pmamonov/PulsePal/CAD/PCB/r2_0/kicad/PulsePalSMT_Rev_0_5.kicad_pcb

## KiCad design CAD/PCB/r2_0/kicad/PulsePalSMT_Rev_0_5.kicad_pcb (2017-06-04)

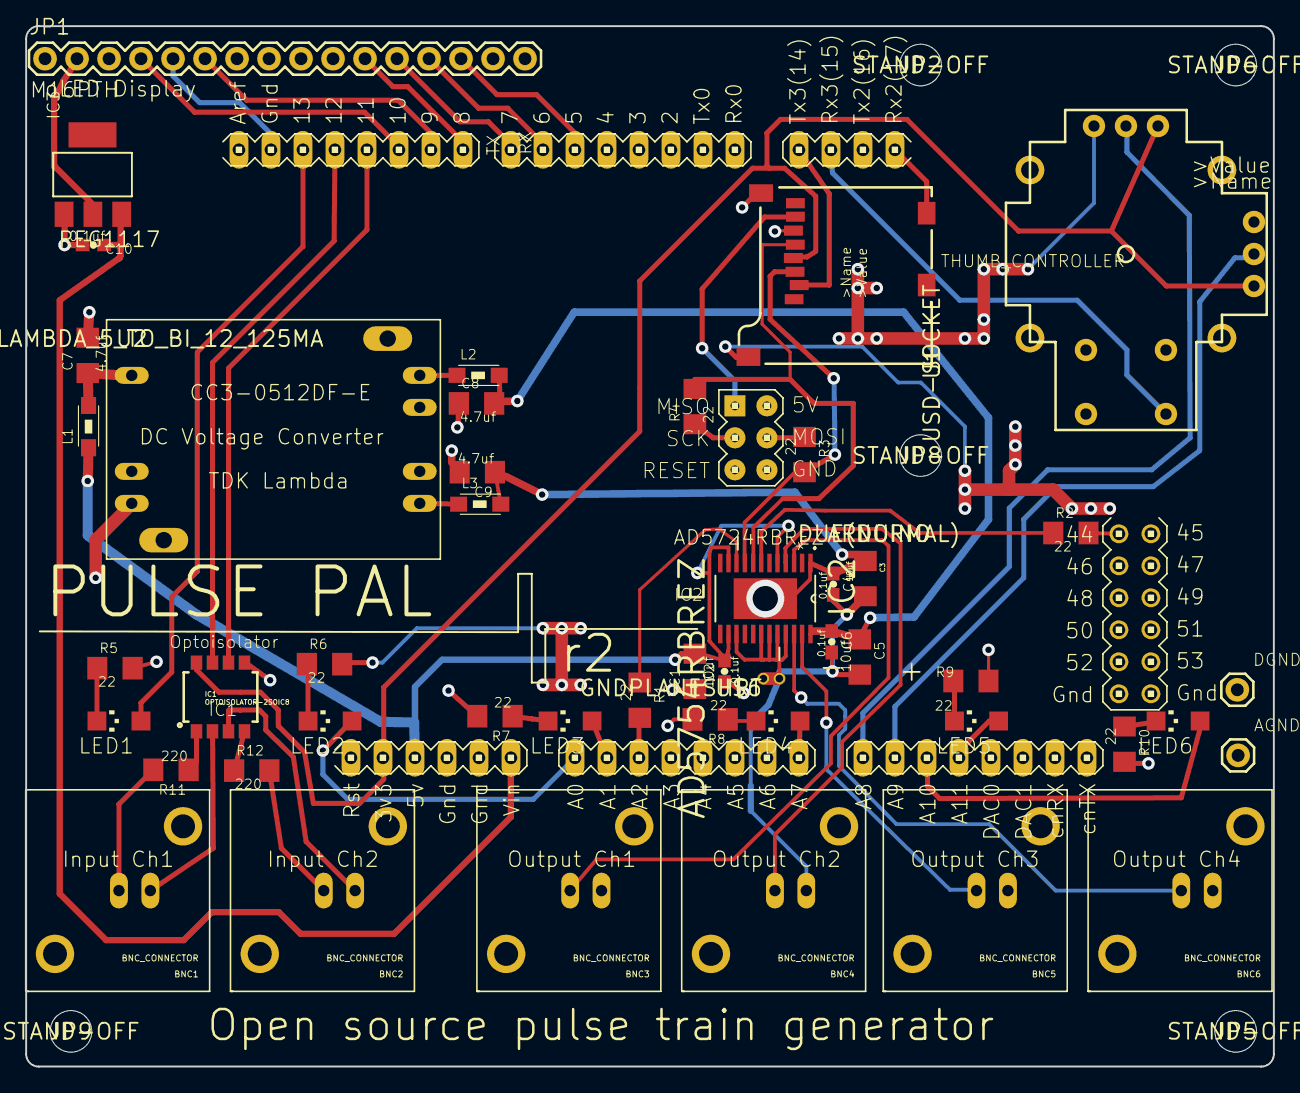
[picture p1: board PulsePalSMT_Rev_0_5.kicad_pcb from above]

Board: 4 copper layers, 99.0 x 82.6 mm, 53 parts (0 on the bottom side), 55 nets.

Parts:
AGND: 1X01
ARDUINO: DUE(NORMAL)
BNC1, BNC2, BNC3, BNC4, BNC5, BNC6: BNC_CONNECTOR
C1, C3, C5: 10uf; 1206
C2, C4, C6, C10: 0.1uf; 0603-CAP
C7, C8, C9: 4.7uf; 1206
DGND: 1X01
IC1: OPTOISOLATOR-2SOIC8; SO08-2
IC2: AD5754RBREZ; SOP65P640X120-25N
IC3: REG1117; SOT223
JP1: M16PTH; 1X16
JP2, JP5, JP6, JP8, JP9: STAND-OFF
L1, L2, L3: 1206
LED1, LED2, LED3, LED4, LED5, LED6: CHIPLED_1206
R1, R2, R3, R4, R5, R6, R7, R8, R9, R10: 22; 1206
R11, R12: 220; 1206
THUMB_CONTROLLER: JOYSTICK
U1: USD-SOCKET; MICROSD_1%3a1
U2: TDK_LAMBDA_5_TO_BI_12_125MA
U$6: GNDPLANESHRT

Connections:
5V: ARDUINO.5V, C1.2, C2.2, IC2.5, IC2.11, IC2.14, L1.1
AGND: AGND.1, BNC3.GND, BNC4.GND, BNC5.GND, BNC6.GND, C3.2, C4.2, C5.2, C6.2, IC2.15, IC2.18, IC2.19, IC2.20, IC2.21, U$6.AGND
GND: ARDUINO.GND1, ARDUINO.GND_, C1.1, C2.1, C7.2, C8.1, C9.2, C10.2, DGND.1, IC1.5, IC3.1, JP1.1, JP1.5, R5.2, R6.2, R7.2, R8.2, R9.2, R10.2, THUMB_CONTROLLER.B2A, THUMB_CONTROLLER.H3, THUMB_CONTROLLER.V3, U1.6, U1.GND1, U1.GND3, U2.P$2, U2.P$3, U2.P$5, U$6.GND
H_NAV: ARDUINO.VIN, C10.1, IC3.3
LED2: ARDUINO.A0, LED2.A
LED3: ARDUINO.A1, LED3.A
LED4: ARDUINO.A7, LED4.A
LED5: ARDUINO.A11, LED5.A
LED6: ARDUINO.A10, LED6.A
MISO1: ARDUINO.MISO, U1.7
unnamed: L2.1, U2.P$7
unnamed: L3.1, U2.P$4
unnamed: BNC3.SIGN, IC2.3
unnamed: BNC4.SIGN, IC2.4
unnamed: BNC5.SIGN, IC2.23
unnamed: BNC6.SIGN, IC2.22
unnamed: BNC1.GND, IC1.2
unnamed: BNC1.SIGN, R11.2
unnamed: BNC2.GND, IC1.3
unnamed: BNC2.SIGN, R12.2
unnamed: ARDUINO.SCK, R4.1
unnamed: ARDUINO.MOSI, R3.1
unnamed: ARDUINO.44, R2.2
unnamed: ARDUINO.A2, R1.2
unnamed: IC2.7, R2.1
unnamed: IC2.10, R1.1
unnamed: ARDUINO.RX3, THUMB_CONTROLLER.B1A
unnamed: ARDUINO.11, IC1.6
unnamed: LED1.C, R5.1
unnamed: LED2.C, R6.1
unnamed: LED3.C, R7.1
unnamed: LED4.C, R8.1
unnamed: LED5.C, R9.1
unnamed: LED6.C, R10.1
unnamed: IC1.1, R11.1
unnamed: IC3.2, JP1.2
unnamed: ARDUINO.12, IC1.7
unnamed: ARDUINO.5, JP1.14
unnamed: ARDUINO.13, LED1.A
unnamed: ARDUINO.10, JP1.4
unnamed: ARDUINO.9, JP1.6
unnamed: ARDUINO.8, JP1.11
unnamed: ARDUINO.7, JP1.12
unnamed: ARDUINO.6, JP1.13
unnamed: IC1.4, R12.1
unnamed: ARDUINO.A8, THUMB_CONTROLLER.H2
unnamed: C5.1, C6.1, C8.2, IC2.24, L2.2
unnamed: C3.1, C4.1, C9.1, IC2.1, IC2.25, L3.2
unnamed: C7.1, L1.2, U2.P$1
unnamed: ARDUINO.A9, THUMB_CONTROLLER.V2
ROMLOAD: ARDUINO.TX3, U1.2
SCK1: IC2.8, R4.2, U1.5
SDA1: IC2.9, R3.2, U1.3
VCC: ARDUINO.3V3, IC1.8, THUMB_CONTROLLER.H1, THUMB_CONTROLLER.V1, U1.4
V_NAV: ARDUINO.RX2, U1.CD1
