pmamonov/PulsePal/(commit log)

2017-06-02 firmware: 2.0.1: fix missing function declarations
    [PulsePal_2_0_1.ino]
2017-06-03 FIXME: PCB/r2_0: convert to kicad
    [PulsePalSMT_Rev_0_5.kicad_pcb, PulsePalSMT_Rev_0_5.sch]
2017-06-04 PCB/r2_0/kicad: 2 layer PCB
    [PulsePalSMT_Rev_0_5.kicad_pcb]
2017-06-05 firmware: 2.0.1: don't hang on SD card failure
    [PulsePal_2_0_1.ino]
2017-06-05 Revert "debug: firmware: 2.0.1: add blinks"
    This reverts commit 436b49206fa35a8956abfd631d87321b70a2f7d2.
    Conflicts:
    Firmware/PulsePal_2_0_1/PulsePal_2_0_1.ino
    [PulsePal_2_0_1.ino]
