pmamonov/PulsePal/(notices)

Notices in the files:
Firmware/PulsePal_2_0_1/PulsePal_2_0_1.ino:
This program is free software: you can redistribute it and/or modify
it under the terms of the GNU General Public License as published by
the Free Software Foundation, version 3.
